EdmarcioCarlos/gadget-07-speedloader-eletrico/README.md

# Speedloader Eletrico

Gadget para airsoft — parte da linha tática preta e coyote.

## Conteúdo
- `3D/` — Modelos OpenSCAD (.scad), STLs prontos para impressão, imagens de referência
- Código fonte na pasta do projeto
- `PREVIA.html` — Documentação visual interativa (abrir no navegador)
- `lib/` — Biblioteca OpenSCAD compartilhada

## Como usar
1. Abra `PREVIA.html` no navegador
2. Imprima os STLs em `3D/stl/` (PETG recomendado)
3. Grave o firmware na placa correspondente

## Licença
Uso pessoal / educacional. Não comercial.

---
*Gerado automaticamente a partir do monorepo GADGETS*
