EdmarcioCarlos/gadget-07-speedloader-eletrico/3D/img/pecas.png

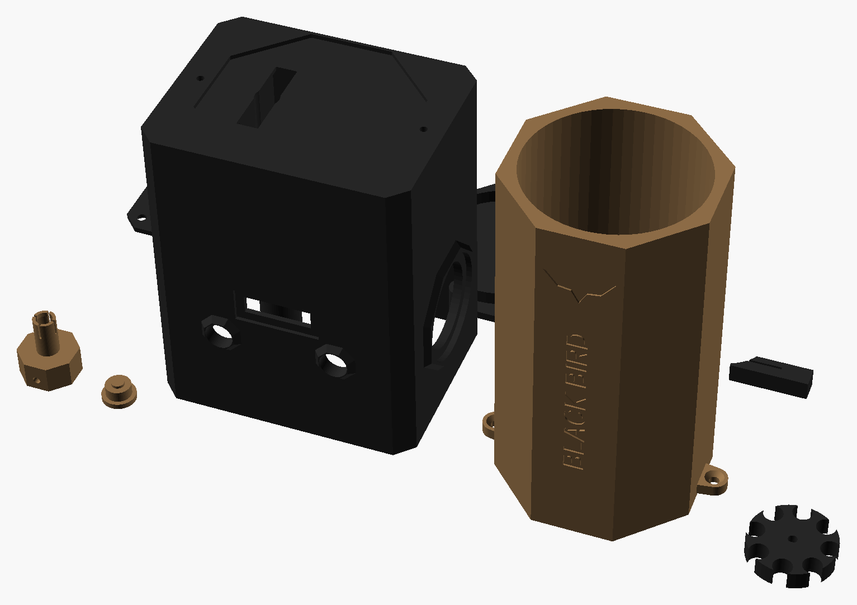
3D/img/pecas.png
