EdmarcioCarlos/gadget-07-speedloader-eletrico/3D/img/pecas_comercial.png

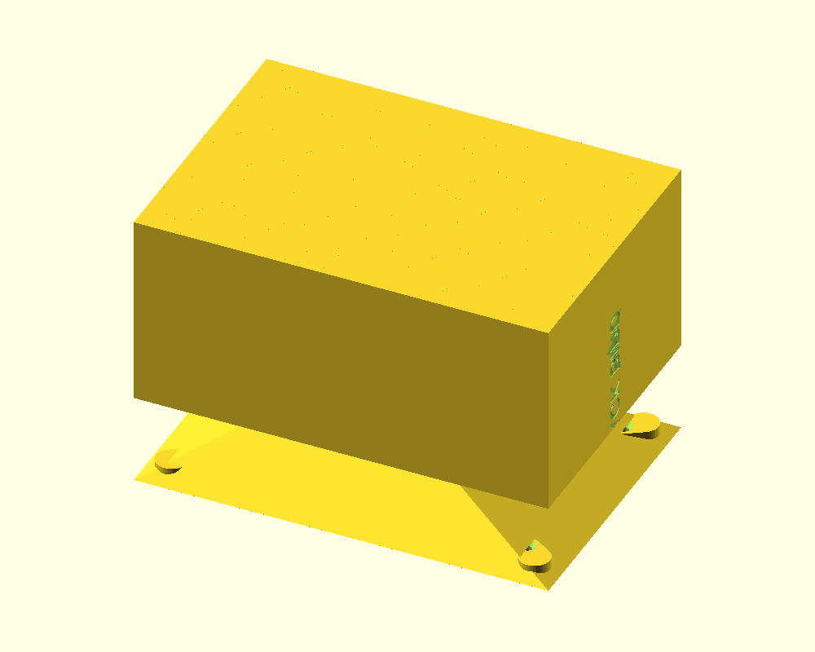
3D/img/pecas_comercial.png
