EdmarcioCarlos/gadget-07-speedloader-eletrico/3D/img/vistas_direita.png

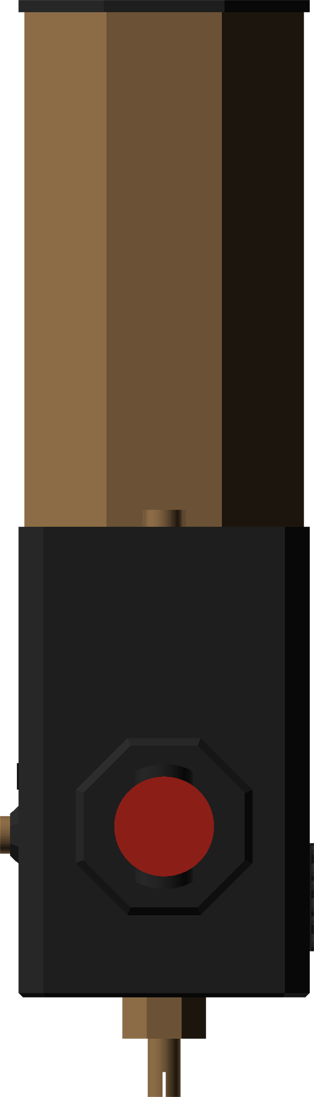
3D/img/vistas_direita.png
