EdmarcioCarlos/gadget-07-speedloader-eletrico/3D/img/vistas_frente.png

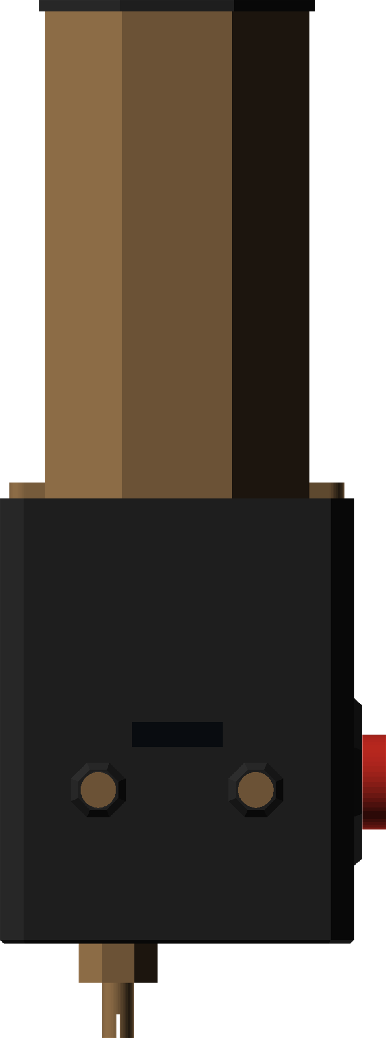
3D/img/vistas_frente.png
