EdmarcioCarlos/gadget-07-speedloader-eletrico/3D/img/vistas_frente_comercial.png

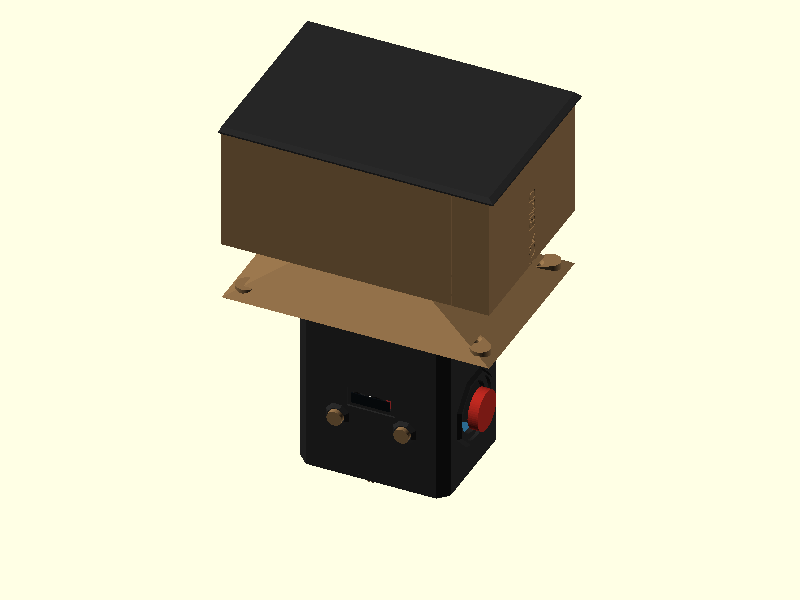
3D/img/vistas_frente_comercial.png
