EdmarcioCarlos/gadget-07-speedloader-eletrico/3D/img/vistas_tras_CORTEtrue.png

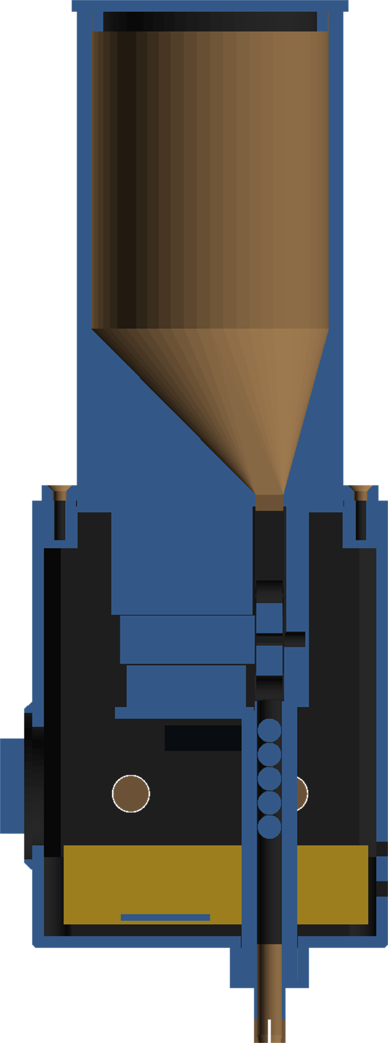
3D/img/vistas_tras_CORTEtrue.png
