EdmarcioCarlos/gadget-07-speedloader-eletrico/3D/stl/roda.stl

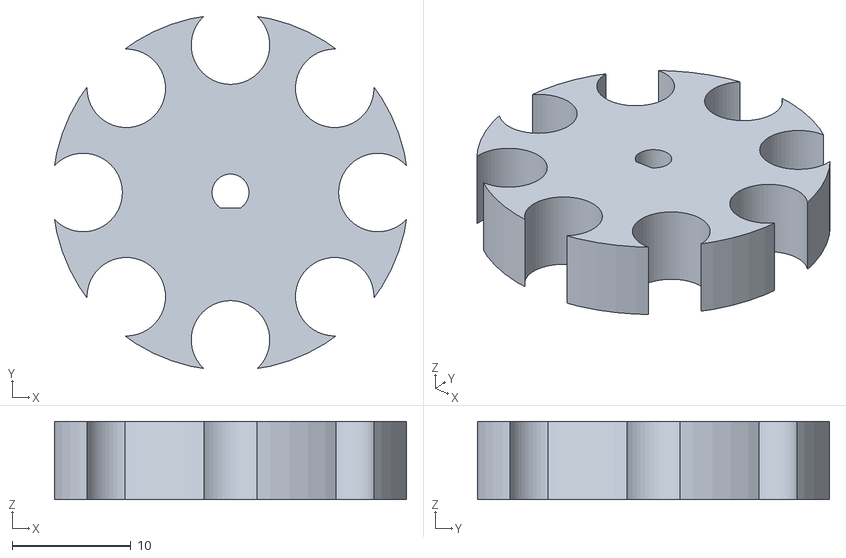
[picture p9: CAD file, 2026-11-12]
3D/stl/roda.stl
29.6 x 29.6 x 6.60
