EdmarcioCarlos/gadget-07-speedloader-eletrico/3D/stl/capa_botao.stl

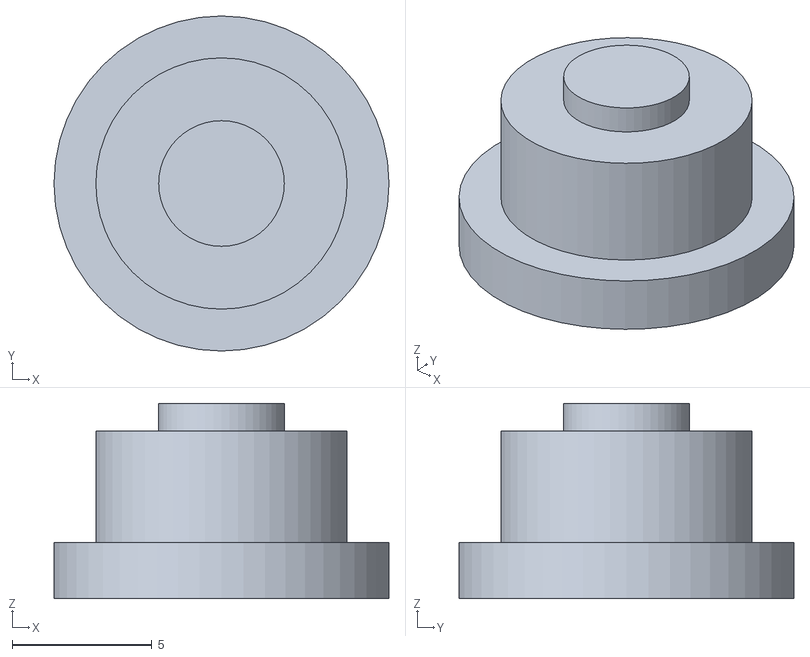
[picture p10: CAD file, 2026-11-12]
3D/stl/capa_botao.stl
12.0 x 12.0 x 6.99
