EdmarcioCarlos/gadget-07-speedloader-eletrico/3D/stl/trava_motor.stl

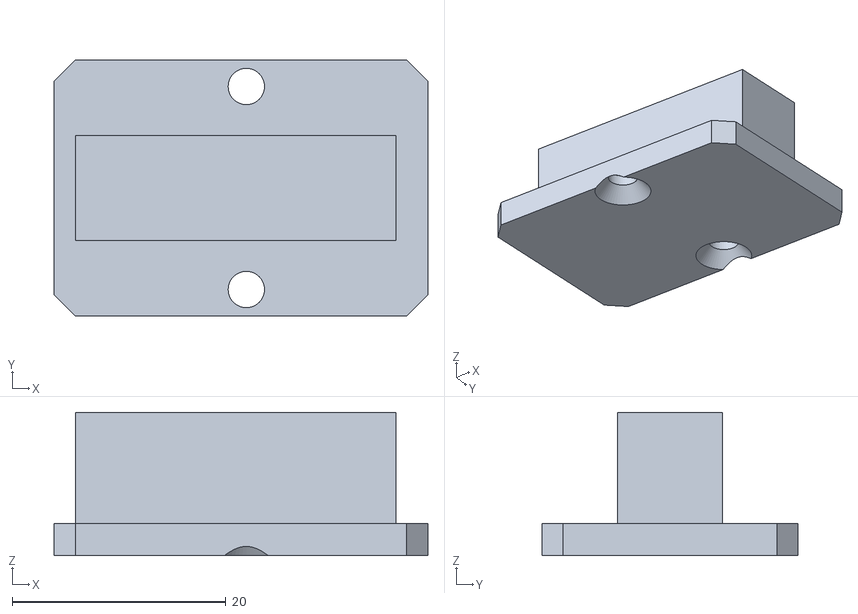
[picture p11: CAD file, 2026-11-12]
3D/stl/trava_motor.stl
35.0 x 24.0 x 13.4
