EdmarcioCarlos/gadget-07-speedloader-eletrico/3D/stl/reservatorio.stl

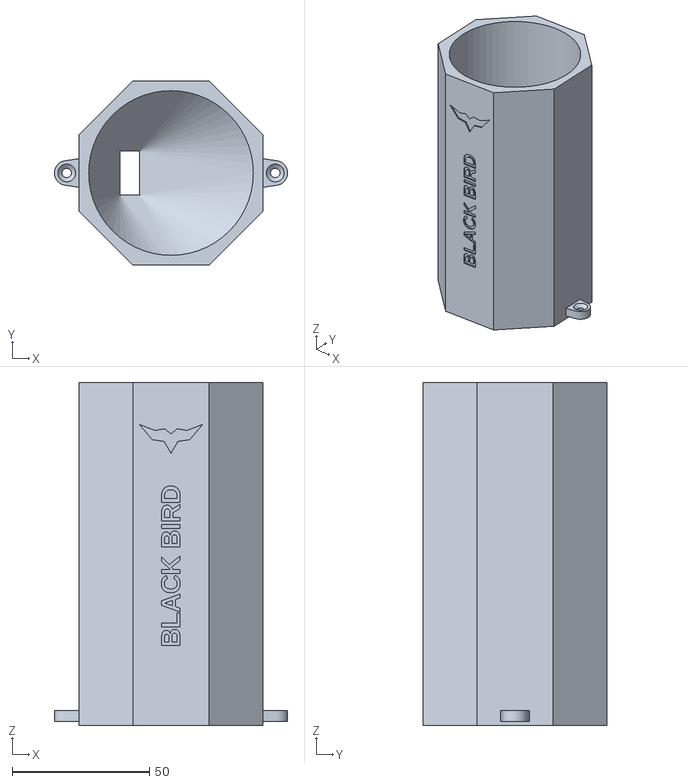
[picture p12: CAD file, 2026-11-12]
3D/stl/reservatorio.stl
85.0 x 67.2 x 125.0
