EdmarcioCarlos/gadget-07-speedloader-eletrico/3D/stl/tampa_reservatorio.stl

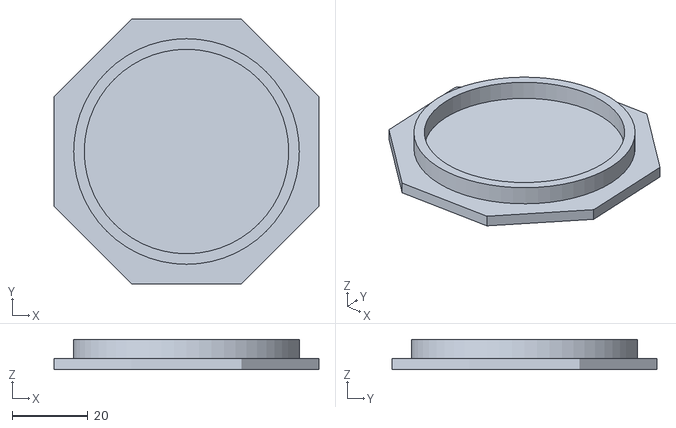
[picture p13: CAD file, 2026-11-12]
3D/stl/tampa_reservatorio.stl
70.0 x 70.0 x 8.00
