EdmarcioCarlos/gadget-07-speedloader-eletrico/3D/stl/trava_roda.stl

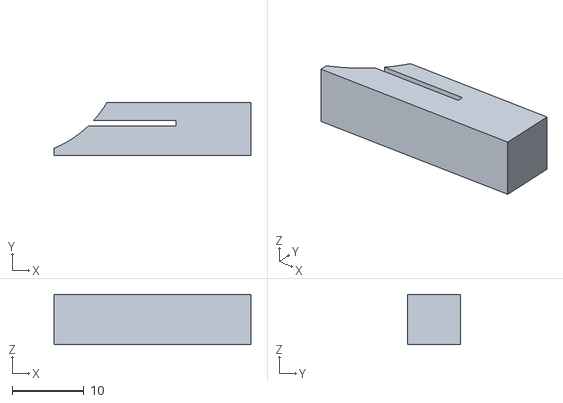
[picture p14: CAD file, 2026-11-12]
3D/stl/trava_roda.stl
27.5 x 7.40 x 7.00
