EdmarcioCarlos/gadget-07-speedloader-eletrico/3D/stl/tampa_inferior.stl

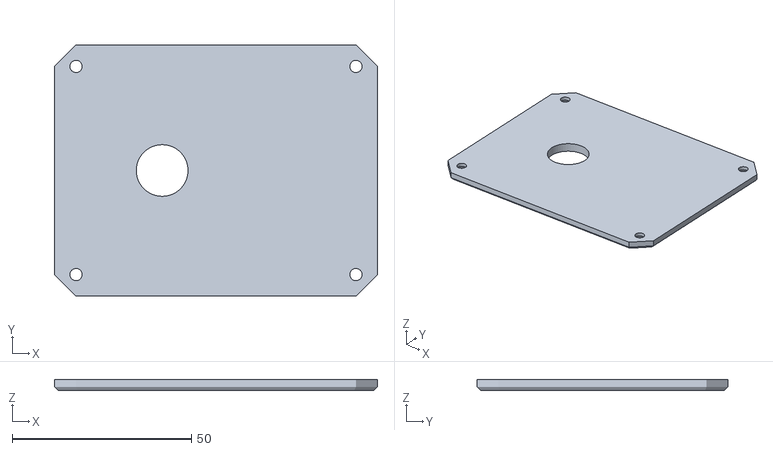
[picture p15: CAD file, 2026-11-12]
3D/stl/tampa_inferior.stl
90.0 x 70.0 x 3.00
