EdmarcioCarlos/gadget-07-speedloader-eletrico/3D/stl/bico_m4.stl

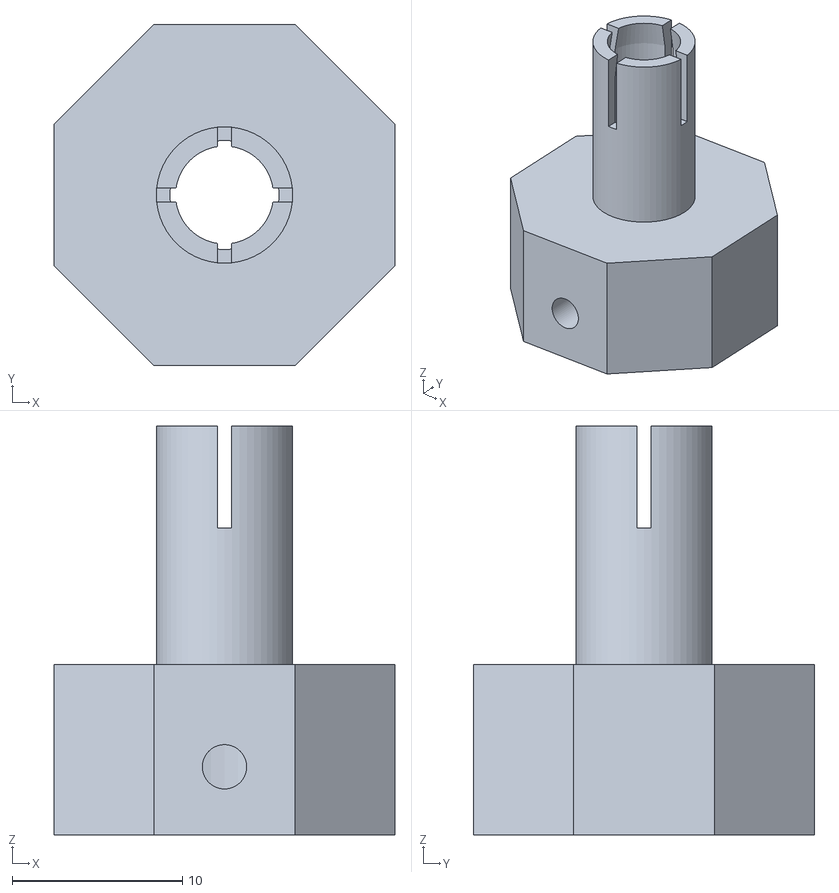
[picture p16: CAD file, 2026-11-12]
3D/stl/bico_m4.stl
20.0 x 20.0 x 24.0
