EdmarcioCarlos/gadget-07-speedloader-eletrico/3D/stl/corpo.stl

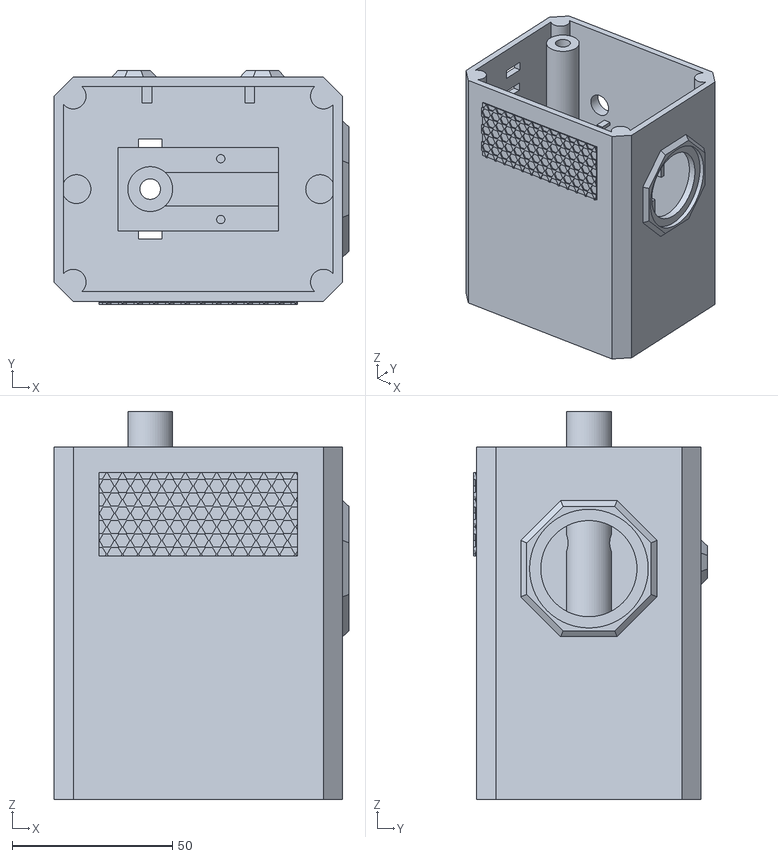
[picture p17: CAD file, 2026-11-12]
3D/stl/corpo.stl
92.0 x 73.0 x 121.0
