EdmarcioCarlos/gadget-07-speedloader-eletrico/(list of files, cad)

Other CAD files:
3D/montagem.scad
3D/pecas.scad
